jdt23/waterSensor/(commit log)

2020-11-29 add water depth value processing, led for value, touch up lcd display
2020-12-01 calibrate depth sensor, add readme
2020-12-03 final working device, with some cleanup
2020-12-03 rotate sensor image
2020-12-03 Revert "rotate sensor image"
    This reverts commit 5369e06bf1d26e53008a72a4ed84a9a8a66d486a.
2020-12-06 add water tank sensor
